wldd22/octa-chord/BOM.csv

Item | Qty | Supplier | Cost/item | Total Cost | link
PCB | 1 | JLCPCB | $13.20 | $13.20 | https://jlcpcb.com/
ESP32-S3-Zero | 1 | Robu | $6.40 | $6.40 | https://robu.in/product/waveshare-esp32-s3-mini-development-board-based-on-esp32-s3fh4r2-dual-core-processor-240mhz-running-frequency-2-4ghz-wi-fi-bluetooth-5/
MPR121 Breakout V12 | 1 | Robocraze | $1.50 | $1.50 | https://robocraze.com/products/mpr121-12-channel-capacitive-touch-sensor-controller-module-i2c-interface
Kailh Choc v1 Low Profile Switches (Burnt Orange) | 1 | NeoMacro | $5.10 | $5.10 | https://neomacro.in/products/kailh-choc-v1-switches?variant=49466990231830
Chocfox CFX Choc Blank Keycaps (1U x 10pcs) | 1 | NeoMacro | $3.70 | $3.70 | https://neomacro.in/products/chocfox-cfx-choc-blank-keycaps?variant=49467026833686
Hongyan EC11H 7CE20P1ZD20 | 2 | Robu | $0.70 | $1.40 | https://robu.in/product/hongyan-ec11h-7ce20p1zd20-rotary-encoder-with-push-button-switch-vertical-plug-in-5-pin/
2.54mm 1x40 Pin Male Header Strip | 1 | Robu | $0.16 | $0.16 | https://robu.in/product/2-54mm-1x40-pin-male-single-row-straight-long-header-strip-pack-of-3/
Estimated total shipping | 1 |  |  | $11.70
