wldd22/octa-chord/pcb/3D models/Bourns Slide Potentiometers/PTA1543.STEP

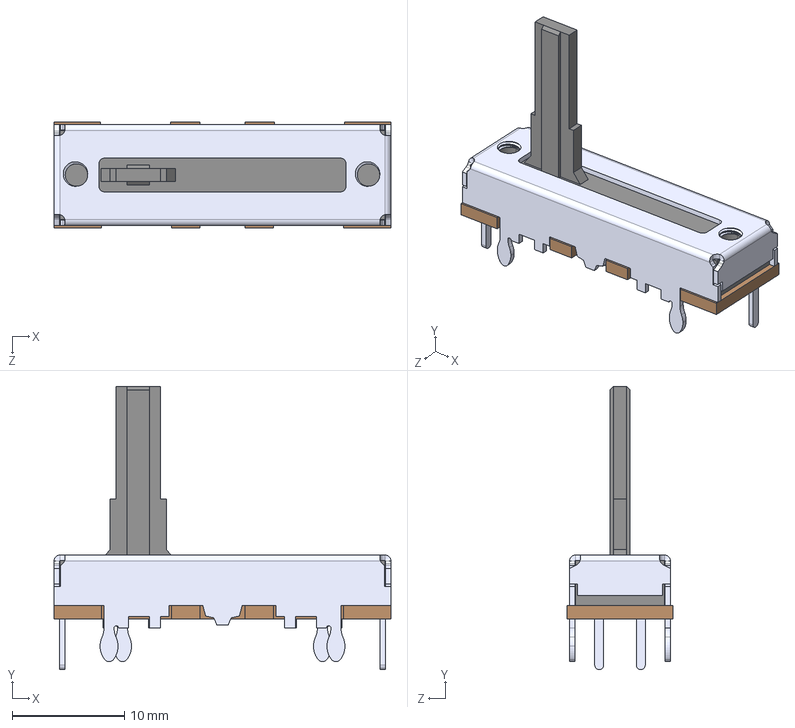
[picture p4: CAD file, 2026-10-22]
pcb/3D models/Bourns Slide Potentiometers/PTA1543.STEP
30.0 x 25.2 x 9.40 mm
