wldd22/octa-chord/pcb/3D models/mpr121_breakout_v13.stl

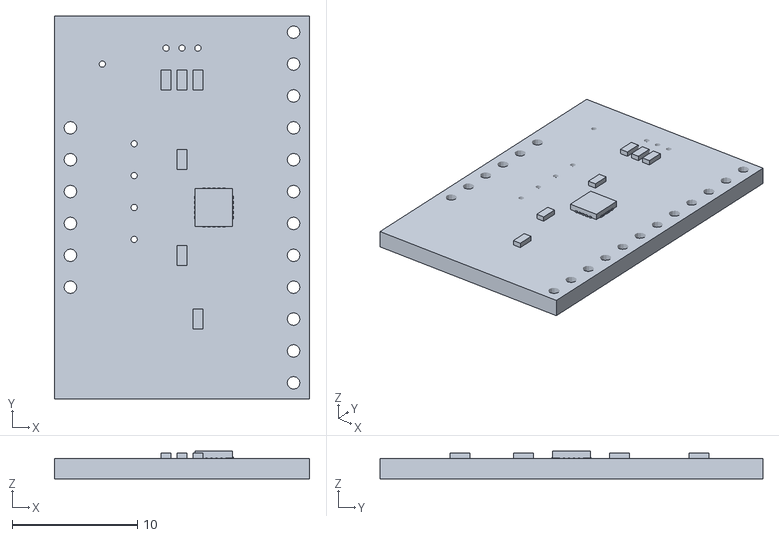
[picture p5: CAD file, 2026-10-23]
pcb/3D models/mpr121_breakout_v13.stl
20.3 x 30.5 x 2.20
