wldd22/octa-chord/pcb/3D models/Bourns Slide Potentiometers/PTA2043.stp

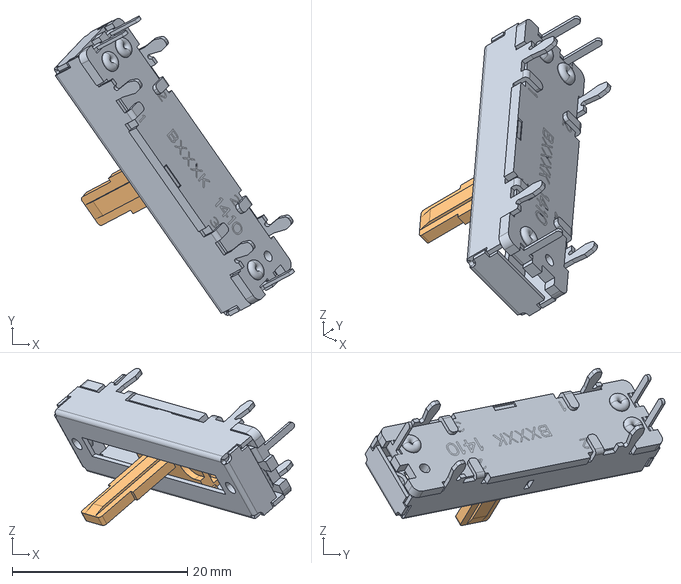
[picture p6: CAD file, 2026-10-22]
pcb/3D models/Bourns Slide Potentiometers/PTA2043.stp
27.4 x 34.2 x 18.0 mm
