wldd22/octa-chord/pcb/3D models/Bourns Slide Potentiometers/PTA4543.stp

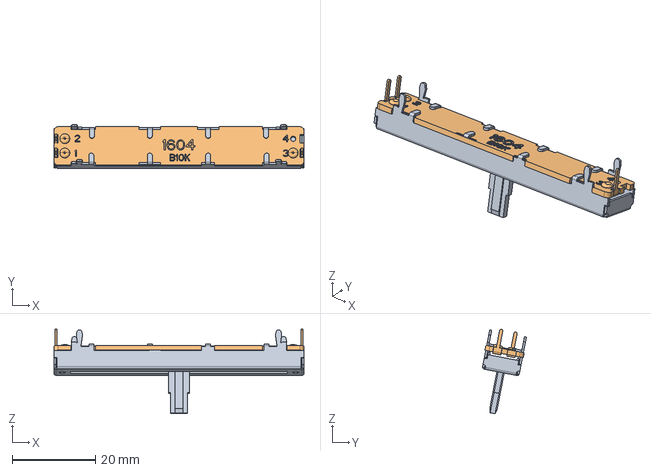
[picture p7: CAD file, 2026-10-22]
pcb/3D models/Bourns Slide Potentiometers/PTA4543.stp
60.0 x 10.6 x 20.3 mm
