wldd22/octa-chord/pcb/octa-chord.kicad_pcb

## KiCad design pcb/octa-chord.kicad_pcb (2026-10-30)

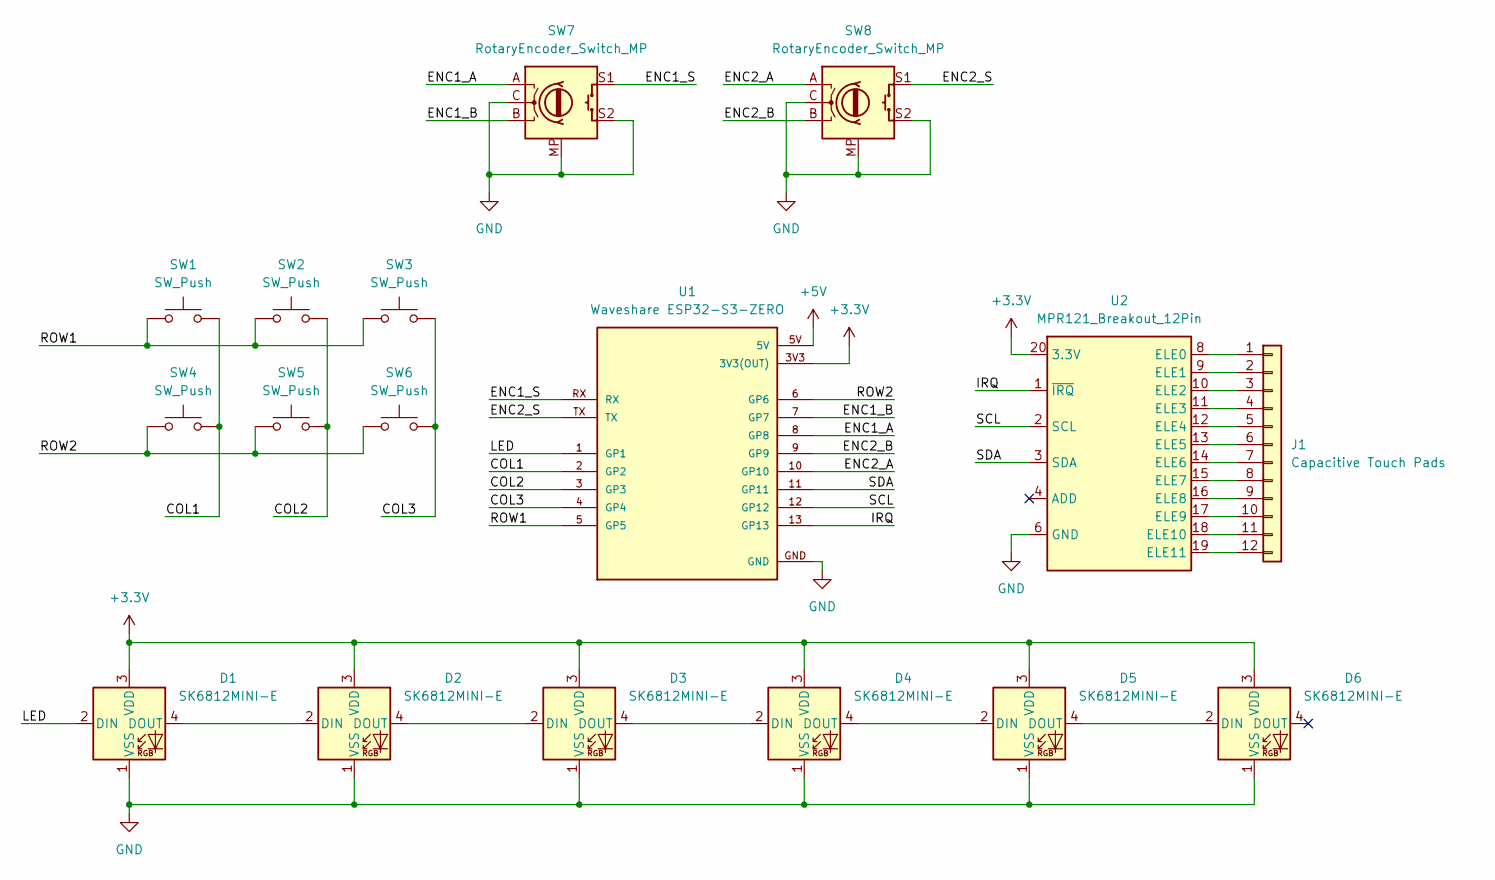
[picture p8: schematic octa-chord.kicad_sch]

Parts:
D1, D2, D3, D4, D5, D6: SK6812MINI-E; LED_SK6812MINI-E_3.2x2.8mm_P1.5mm_ReverseMount
J1: Capacitive Touch Pads; Capactive Key Octave
SW1, SW2, SW3, SW4, SW5, SW6: SW_Push; Kailh Choc Low-Profile Switches
SW7, SW8: RotaryEncoder_Switch_MP; RotaryEncoder_Alps_EC11E-Switch_Vertical_H20mm
U1: Waveshare ESP32-S3-ZERO; Waveshare ESP32-S3-Zero; PARTREV NA
U2: MPR121_Breakout_12Pin

Connections:
+3.3V: D1.3 (VDD), D2.3 (VDD), D3.3 (VDD), D4.3 (VDD), D5.3 (VDD), D6.3 (VDD), U1.3V3 (3V3(OUT)), U2.20 (3.3V)
+5V: U1.5V
/COL1: SW1.2, SW4.2, U1.2 (GP2)
/COL2: SW2.2, SW5.2, U1.3 (GP3)
/COL3: SW3.2, SW6.2, U1.4 (GP4)
/ENC1_A: SW7.A, U1.8 (GP8)
/ENC1_B: SW7.B, U1.7 (GP7)
/ENC1_S: SW7.S1, U1.RX
/ENC2_A: SW8.A, U1.10 (GP10)
/ENC2_B: SW8.B, U1.9 (GP9)
/ENC2_S: SW8.S1, U1.TX
/IRQ: U1.13 (GP13), U2.1 (~IRQ)
/LED: D1.2 (DIN), U1.1 (GP1)
/ROW1: SW1.1, SW2.1, SW3.1, U1.5 (GP5)
/ROW2: SW4.1, SW5.1, SW6.1, U1.6 (GP6)
/SCL: U1.12 (GP12), U2.2 (SCL)
/SDA: U1.11 (GP11), U2.3 (SDA)
GND: D1.1 (VSS), D2.1 (VSS), D3.1 (VSS), D4.1 (VSS), D5.1 (VSS), D6.1 (VSS), SW7.C, SW7.MP, SW7.S2, SW8.C, SW8.MP, SW8.S2, U1.GND, U2.6 (GND)
unnamed: D1.4 (DOUT), D2.2 (DIN)
unnamed: D2.4 (DOUT), D3.2 (DIN)
unnamed: D3.4 (DOUT), D4.2 (DIN)
unnamed: D4.4 (DOUT), D5.2 (DIN)
unnamed: D5.4 (DOUT), D6.2 (DIN)
unnamed: J1.1, U2.8 (ELE0)
unnamed: J1.2, U2.9 (ELE1)
unnamed: J1.3, U2.10 (ELE2)
unnamed: J1.4, U2.11 (ELE3)
unnamed: J1.5, U2.12 (ELE4)
unnamed: J1.6, U2.13 (ELE5)
unnamed: J1.7, U2.14 (ELE6)
unnamed: J1.8, U2.15 (ELE7)
unnamed: J1.9, U2.16 (ELE8)
unnamed: J1.10, U2.17 (ELE9)
unnamed: J1.11, U2.18 (ELE10)
unnamed: J1.12, U2.19 (ELE11)

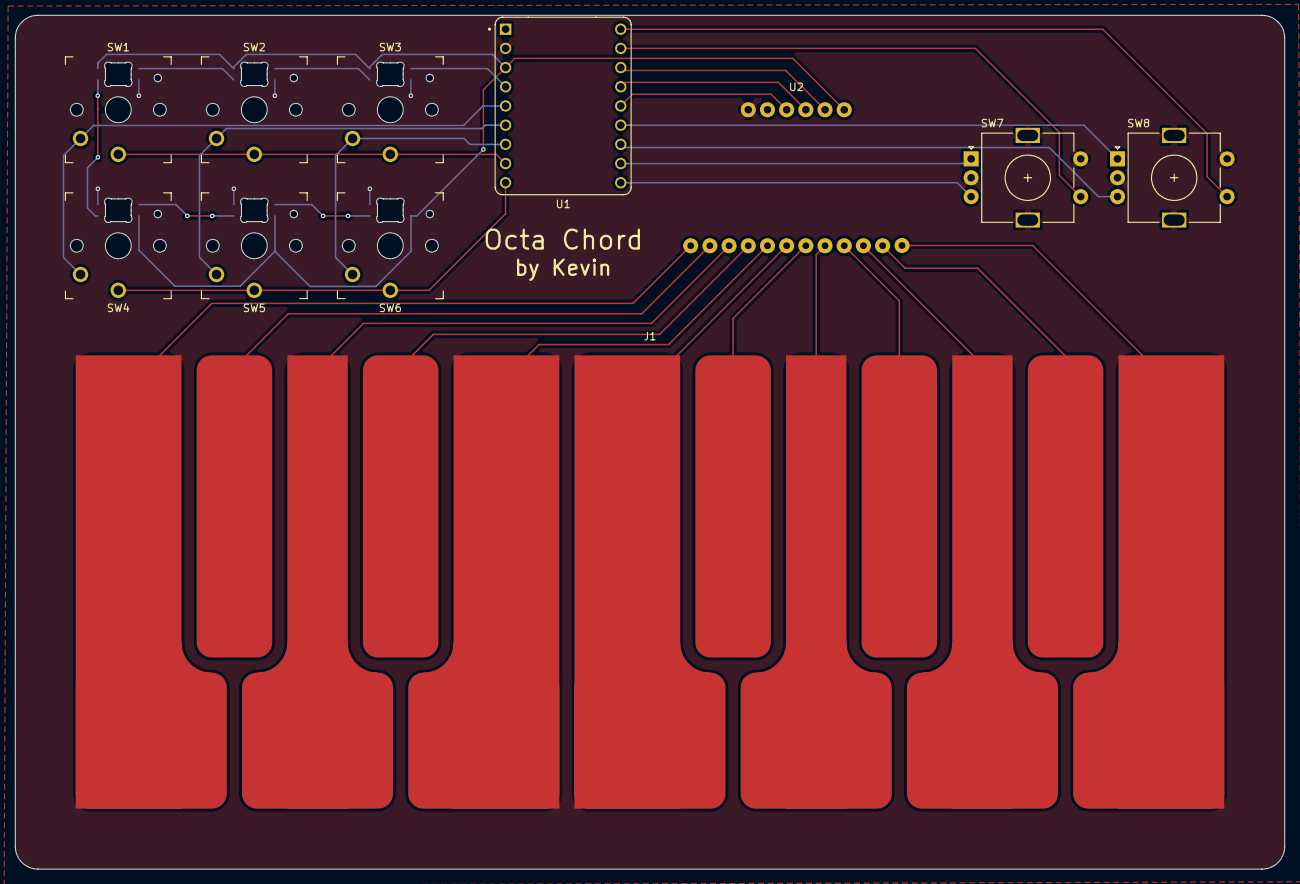
[picture p9: board octa-chord.kicad_pcb from above]

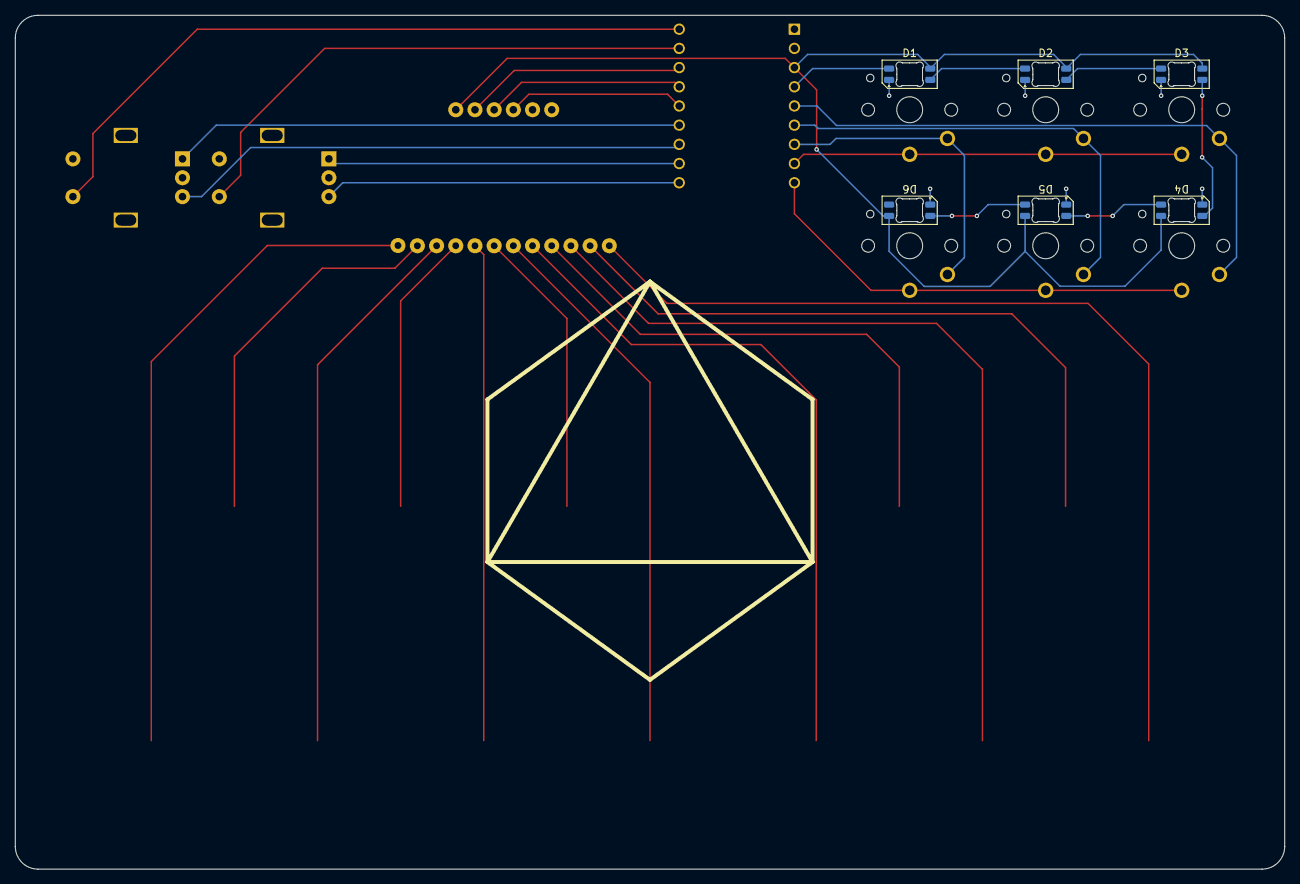
[picture p10: board octa-chord.kicad_pcb from below]

Board: 2 copper layers, 168.0 x 113.0 mm, 17 parts (6 on the bottom side), 34 nets.
