wldd22/octa-chord/(commit log)

2026-10-23 Create schematic and capacitive touch footprint
2026-10-23 Update schematic
2026-10-23 Upload schematic.png
2026-10-23 Update schematic from 3 LEDs to 4
2026-10-23 Modified schematic, routed PCB
2026-10-24 Add silkscreen graphics
2026-10-24 Upload pcb.png
2026-10-24 Update PCB
2026-10-24 Add gerber files for PCB production
2026-10-25 Modify schematic and PCB
2026-10-25 Regenerate gerber files
2026-10-25 Round capacitive pad corners
